ciruschakma/Design-Project-Gesture-Based-Device-Controller/README.md

# Design-Project-Gesture-Based-Device-Controller
