ciruschakma/Design-Project-Gesture-Based-Device-Controller/SchematicProject.pdf

5V

3.3V

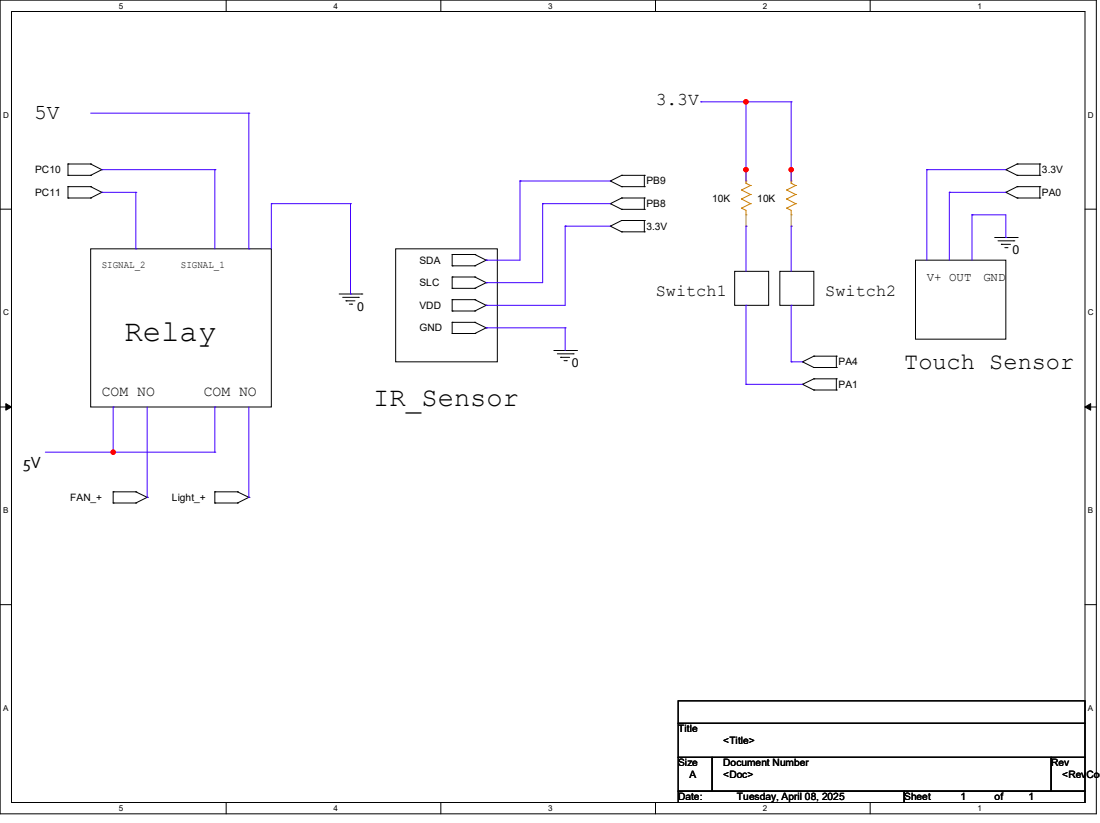
[picture p8: page 1]
SIGNAL_2; SIGNAL_1; Relay; COM NO; IR_Sensor; Switch1; Switch2; V+ OUT; Touch Sensor; GND; FAN_+; Light_+; SDA; SLC; VDD; Title; Size; Document Number; Rev; Date:; Sheet; <Doc>; <RevCode>; <Title>; Tuesday, April 08, 2025
