ciruschakma/Design-Project-Gesture-Based-Device-Controller/Codes/PAJ7620U2.h

#ifndef _PAJ7620U2_
#define _PAJ7620U2_

// I2C address
#define PAJ7620U2_I2C_ADDRESS    (0x73 << 1)

// Register Bank select
#define PAJ_BANK_SELECT          0xEF    // Bank0=0x00, Bank1=0x01

// Register Bank 0 (only the ones needed for gesture detection)
#define PAJ_SUSPEND              0x03    // I2C suspend command
#define PAJ_INT_FLAG1_MASK       0x41    // Gesture detection interrupt flag mask
#define PAJ_INT_FLAG2_MASK       0x42    // Gesture detection interrupt flag mask (unused here)
#define PAJ_INT_FLAG1            0x43    // Gesture detection interrupt flag
#define PAJ_INT_FLAG2            0x44    // Gesture detection interrupt flag (unused here)

// Keep only Up/Down/Left/Right gesture definitions
#define PAJ_UP                   0x01 
#define PAJ_DOWN                 0x02
#define PAJ_LEFT                 0x04 
#define PAJ_RIGHT                0x08

// Initialize array size macros (only for the arrays we use)
#define Init_Array               (sizeof(Init_Register_Array) / 2)
#define Gesture_Array_SIZE       (sizeof(Init_Gesture_Array) / 2)

// Power up initialization array
const unsigned char Init_Register_Array[][2] = {
    {0xEF, 0x00},
    {0x37, 0x07},
    {0x38, 0x17},
    {0x39, 0x06},
    {0x41, 0x00},
    {0x42, 0x00},
    {0x46, 0x2D},
    {0x47, 0x0F},
    {0x48, 0x3C},
    {0x49, 0x00},
    {0x4A, 0x1E},
    {0x4C, 0x20},
    {0x51, 0x10},
    {0x5E, 0x10},
    {0x60, 0x27},
    {0x80, 0x42},
    {0x81, 0x44},
    {0x82, 0x04},
    {0x8B, 0x01},
    {0x90, 0x06},
    {0x95, 0x0A},
    {0x96, 0x0C},
    {0x97, 0x05},
    {0x9A, 0x14},
    {0x9C, 0x3F},
    {0xA5, 0x19},
    {0xCC, 0x19},
    {0xCD, 0x0B},
    {0xCE, 0x13},
    {0xCF, 0x64},
    {0xD0, 0x21},
    {0xEF, 0x01},
    {0x02, 0x0F},
    {0x03, 0x10},
    {0x04, 0x02},
    {0x25, 0x01},
    {0x27, 0x39},
    {0x28, 0x7F},
    {0x29, 0x08},
    {0x3E, 0xFF},
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
};

// Gesture register initialization array
const unsigned char Init_Gesture_Array[][2] = {
    {0xEF, 0x00},
    {0x41, 0x00},
    {0x42, 0x00},
    {0xEF, 0x00},
    {0x48, 0x3C},
    {0x49, 0x00},
    {0x51, 0x10},
    {0x83, 0x20},
    {0x9F, 0xF9},
    {0xEF, 0x01},
    {0x01, 0x1E},
    {0x02, 0x0F},
    {0x03, 0x10},
    {0x04, 0x02},
    {0x41, 0x40},
    {0x43, 0x30},
    {0x65, 0x96},
    {0x66, 0x00},
    {0x67, 0x97},
    {0x68, 0x01},
    {0x69, 0xCD},
    {0x6A, 0x01},
    {0x6B, 0xB0},
    {0x6C, 0x04},
    {0x6D, 0x2C},
    {0x6E, 0x01},
    {0x74, 0x00},
    {0xEF, 0x00},
    {0x41, 0xFF},
    {0x42, 0x01},
};

// Function prototype for sensor initialization
unsigned char PAJ7620U2_init(void);

#endif
